lablabla/MoTrotten/PCB/UI_Board/GMT020-02 TFT SPI 240x320.STEP

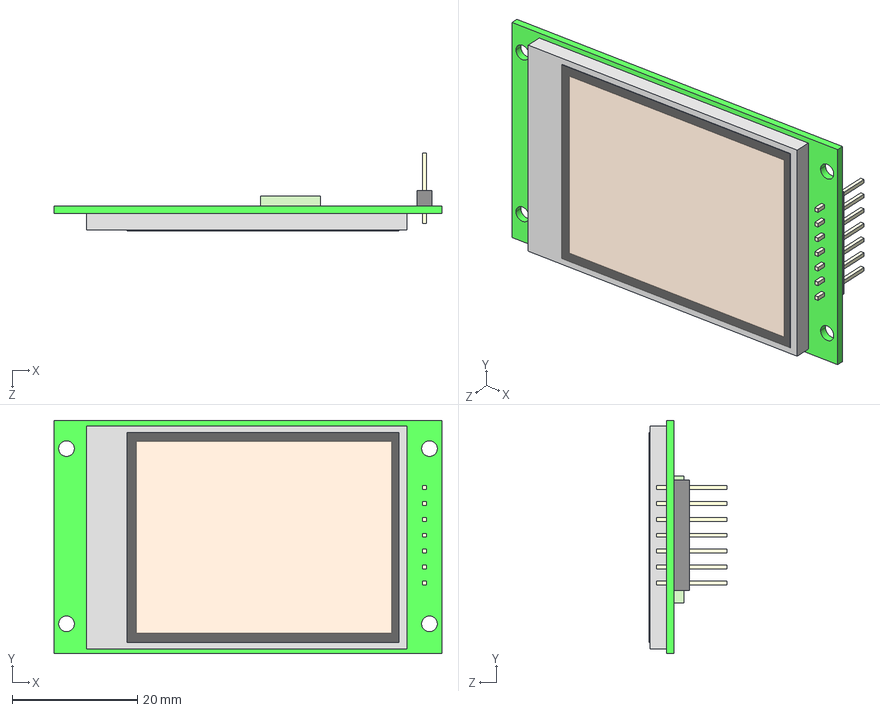
[picture p1: CAD file, 2026-07-06]
PCB/UI_Board/GMT020-02 TFT SPI 240x320.STEP
62.0 x 37.3 x 12.4 mm
