lablabla/MoTrotten/PCB/UI_Board/UI_Board.step

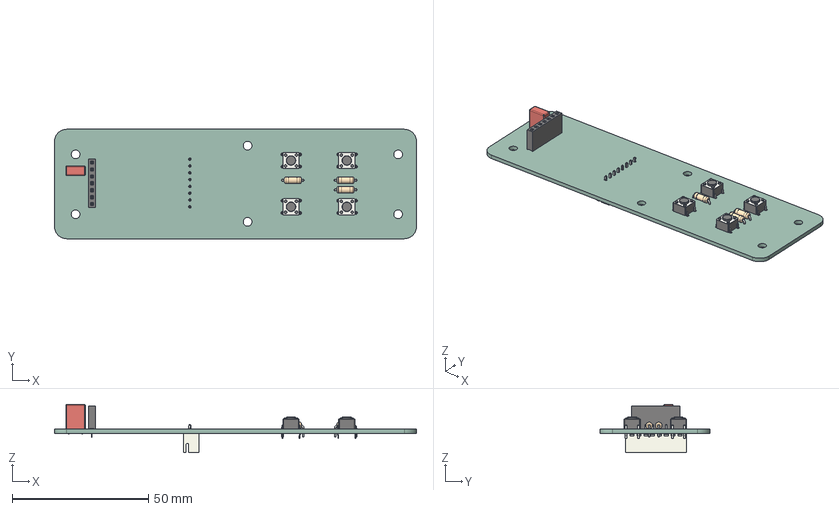
[picture p2: CAD file, 2026-07-06]
PCB/UI_Board/UI_Board.step
133.0 x 40.2 x 17.7 mm
C_Rect_L7.2mm_W3.5mm_P5.00mm_FKS2_FKP2_MKS2_MKP2
R_Axial_DIN0207_L6.3mm_D2.5mm_P7.62mm_Horizontal x 3
SW_PUSH_6mm x 4
PinSocket_1x07_P2.54mm_Vertical
JST_XH_B8B-XH-A_1x08_P2.50mm_Vertical
UI_Board_PCB
