lablabla/MoTrotten/PCB/Main_Board/Main_Board.pdf

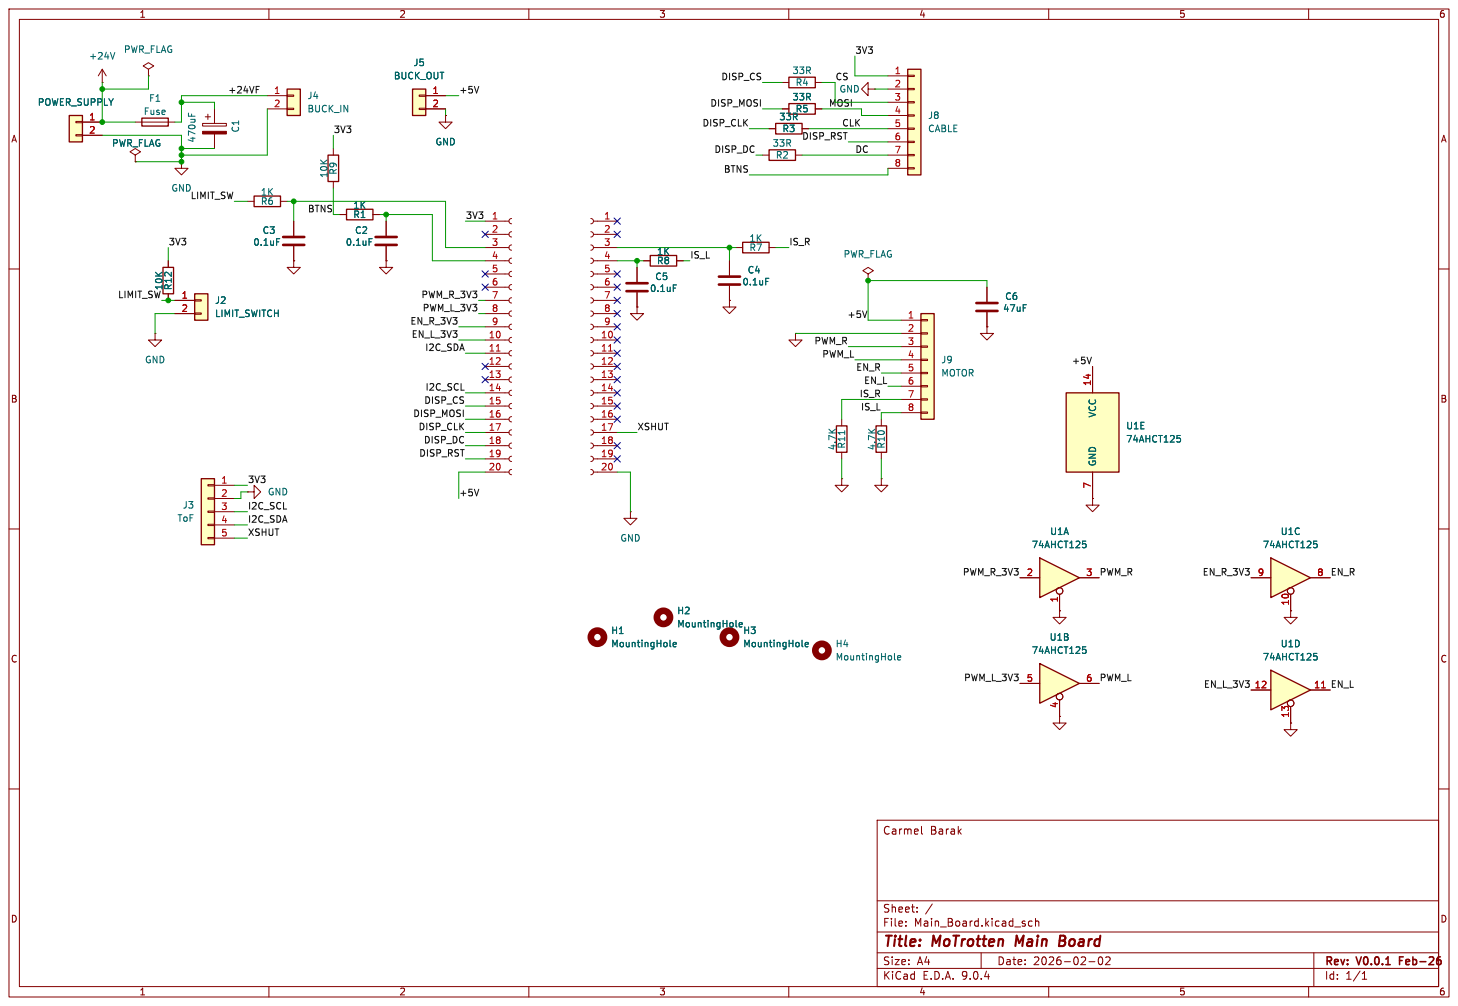
[picture p3: page 1]

Id: 1/1 Title: MoTrotten Main Board
