lablabla/MoTrotten/PCB/UI_Board/UI_Board.pdf

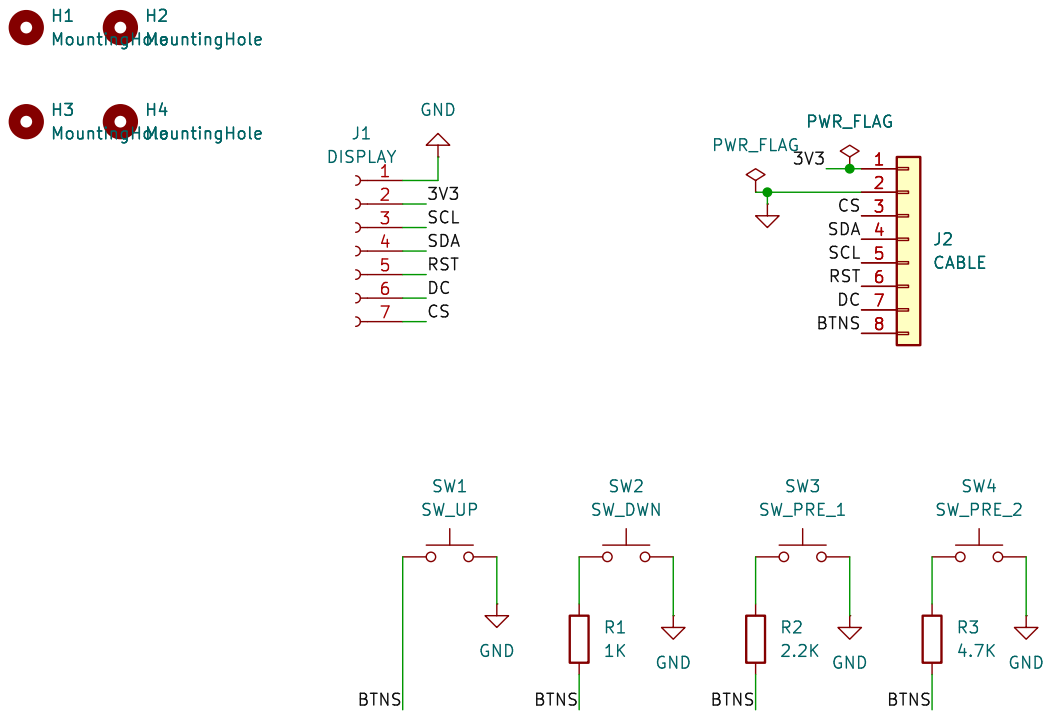
[picture p4: page 1]
