lablabla/MoTrotten/PCB/UI_Board/UI_Board.kicad_pcb

## KiCad design PCB/UI_Board/UI_Board.kicad_pcb (2026-07-06)

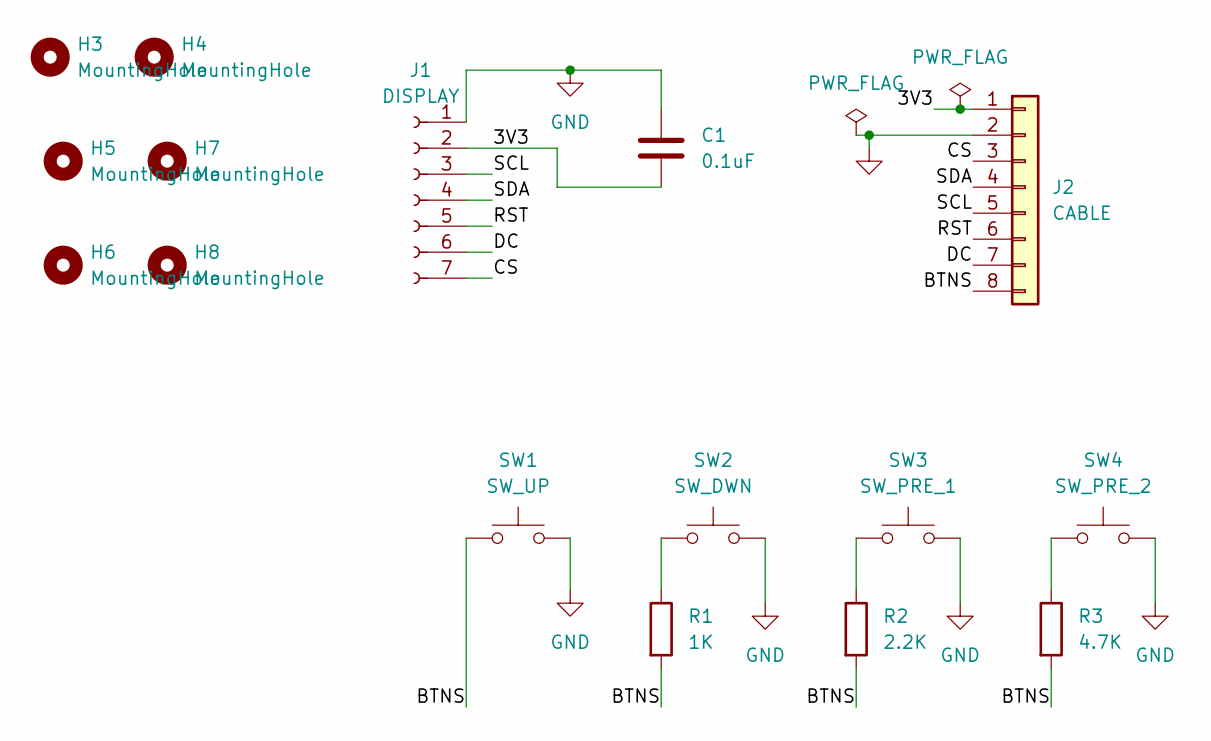
[picture p5: schematic UI_Board.kicad_sch, Motrotten UI]

Parts:
C1: 0.1uF; C_Rect_L7.2mm_W3.5mm_P5.00mm_FKS2_FKP2_MKS2_MKP2
H3, H4, H5, H6, H7, H8: MountingHole; MountingHole_3.2mm_M3
J1: DISPLAY; PinSocket_1x07_P2.54mm_Vertical
J2: CABLE; JST_XH_B8B-XH-A_1x08_P2.50mm_Vertical
R1: 1K; R_Axial_DIN0207_L6.3mm_D2.5mm_P7.62mm_Horizontal
R2: 2.2K; R_Axial_DIN0207_L6.3mm_D2.5mm_P7.62mm_Horizontal
R3: 4.7K; R_Axial_DIN0207_L6.3mm_D2.5mm_P7.62mm_Horizontal
SW1: SW_UP; SW_PUSH_6mm
SW2: SW_DWN; SW_PUSH_6mm
SW3: SW_PRE_1; SW_PUSH_6mm
SW4: SW_PRE_2; SW_PUSH_6mm

Connections:
/3V3: C1.2, J1.2, J2.1
/BTNS: J2.8, R1.2, R2.2, R3.2, SW1.1
/CS: J1.7, J2.3
/DC: J1.6, J2.7
/RST: J1.5, J2.6
/SCL: J1.3, J2.5
/SDA: J1.4, J2.4
GND: C1.1, J1.1, J2.2, SW1.2, SW2.2, SW3.2, SW4.2
unnamed: R1.1, SW2.1
unnamed: R2.1, SW3.1
unnamed: R3.1, SW4.1

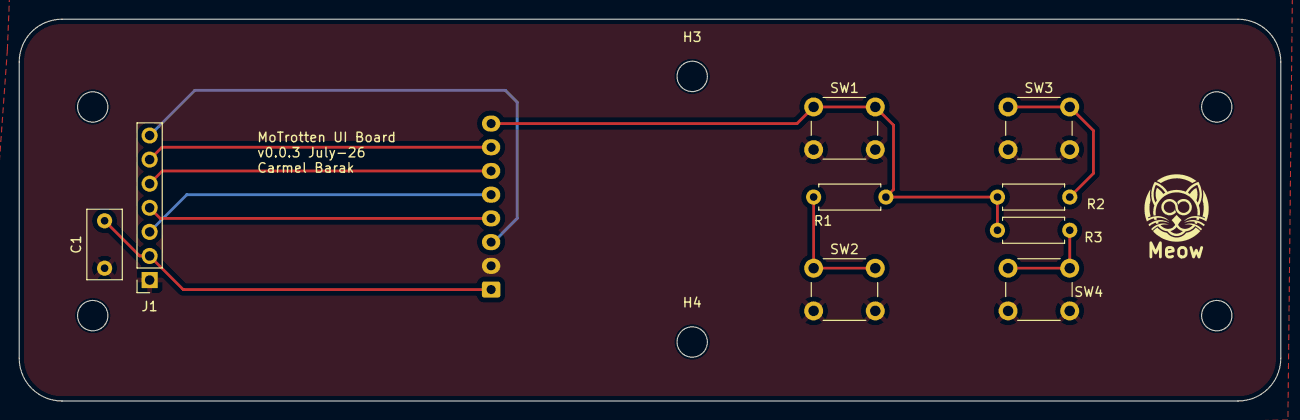
[picture p6: board UI_Board.kicad_pcb from above]

Board: 2 copper layers, 133.0 x 40.2 mm, 16 parts (1 on the bottom side), 11 nets.
