lablabla/MoTrotten/PCB/Main_Board/Main_Board.kicad_pcb

## KiCad design PCB/Main_Board/Main_Board.kicad_pcb (2026-07-06)

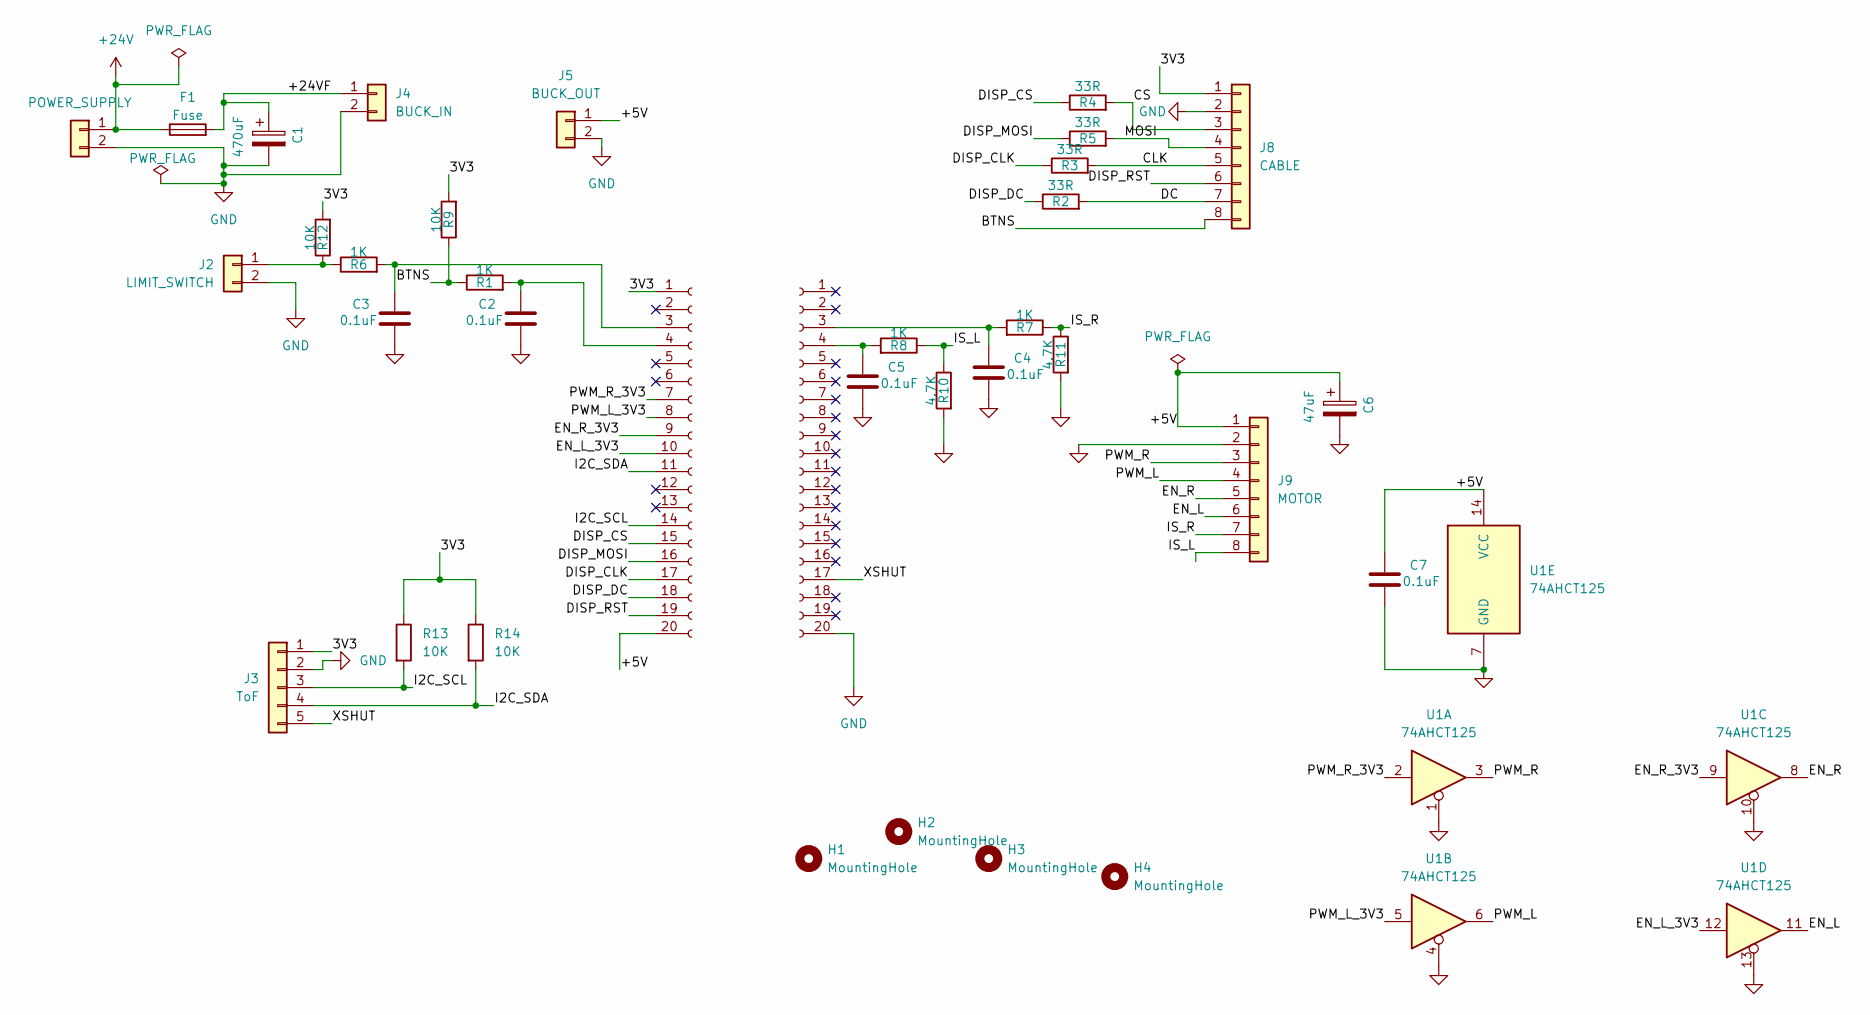
[picture p7: schematic Main_Board.kicad_sch, MoTrotten Main Board]

Parts:
C1: 470uF; CP_Radial_D10.0mm_P5.00mm
C2, C3, C4, C5, C7: 0.1uF; C_Rect_L7.2mm_W3.5mm_P5.00mm_FKS2_FKP2_MKS2_MKP2
C6: 47uF; CP_Radial_D10.0mm_P5.00mm
F1: Fuse; Fuseholder_Cylinder-5x20mm_Stelvio-Kontek_PTF78_Horizontal_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
H1, H2, H3, H4: MountingHole; MountingHole_3.2mm_M3
J1: POWER_SUPPLY; TerminalBlock_bornier-2_P5.08mm
J2: LIMIT_SWITCH; JST_PH_B2B-PH-K_1x02_P2.00mm_Vertical
J3: ToF; JST_PH_B5B-PH-K_1x05_P2.00mm_Vertical
J4: BUCK_IN; TerminalBlock_bornier-2_P5.08mm
J5: BUCK_OUT; TerminalBlock_bornier-2_P5.08mm
J6: ESP32_Left; PinSocket_1x20_P2.54mm_Vertical
J7: ESP32_Right; PinSocket_1x20_P2.54mm_Vertical
J8: CABLE; JST_XH_B8B-XH-A_1x08_P2.50mm_Vertical
J9: MOTOR; JST_XH_B8B-XH-A_1x08_P2.50mm_Vertical
R1, R6, R7, R8: 1K; R_Axial_DIN0207_L6.3mm_D2.5mm_P7.62mm_Horizontal
R2, R3, R4, R5: 33R; R_Axial_DIN0207_L6.3mm_D2.5mm_P7.62mm_Horizontal
R9, R12, R13, R14: 10K; R_Axial_DIN0207_L6.3mm_D2.5mm_P7.62mm_Horizontal
R10, R11: 4.7K; R_Axial_DIN0207_L6.3mm_D2.5mm_P7.62mm_Horizontal
U1: 74AHCT125; DIP-14_W7.62mm

Connections:
+24V: F1.1, J1.1
/3V3: J3.1, J6.1, J8.1, R9.2, R12.2, R13.1, R14.1
/+5V: C6.1, C7.1, J5.1, J6.20, J9.1, U1.14 (VCC)
/+24VF: C1.1, F1.2, J4.1
/BTNS: J8.8, R1.1, R9.1
/CLK: J8.5, R3.2
/CS: J8.3, R4.2
/DC: J8.7, R2.2
/DISP_CLK: J6.17, R3.1
/DISP_CS: J6.15, R4.1
/DISP_DC: J6.18, R2.1
/DISP_MOSI: J6.16, R5.1
/DISP_RST: J6.19, J8.6
/EN_L: J9.6, U1.11
/EN_L_3V3: J6.10, U1.12
/EN_R: J9.5, U1.8
/EN_R_3V3: J6.9, U1.9
/I2C_SCL: J3.3, J6.14, R13.2
/I2C_SDA: J3.4, J6.11, R14.2
/IS_L: J9.8, R8.1, R10.1
/IS_R: J9.7, R7.1, R11.1
/MOSI: J8.4, R5.2
/PWM_L: J9.4, U1.6
/PWM_L_3V3: J6.8, U1.5
/PWM_R: J9.3, U1.3
/PWM_R_3V3: J6.7, U1.2
/XSHUT: J3.5, J7.17
GND: C1.2, C2.2, C3.2, C4.2, C5.2, C6.2, C7.2, J1.2, J2.2, J3.2, J4.2, J5.2, J7.20, J8.2, J9.2, R10.2, R11.2, U1.1, U1.4, U1.7 (GND), U1.10, U1.13
unnamed: J2.1, R6.1, R12.1
unnamed: C3.1, J6.3, R6.2
unnamed: C2.1, J6.4, R1.2
unnamed: C4.1, J7.3, R7.2
unnamed: C5.1, J7.4, R8.2

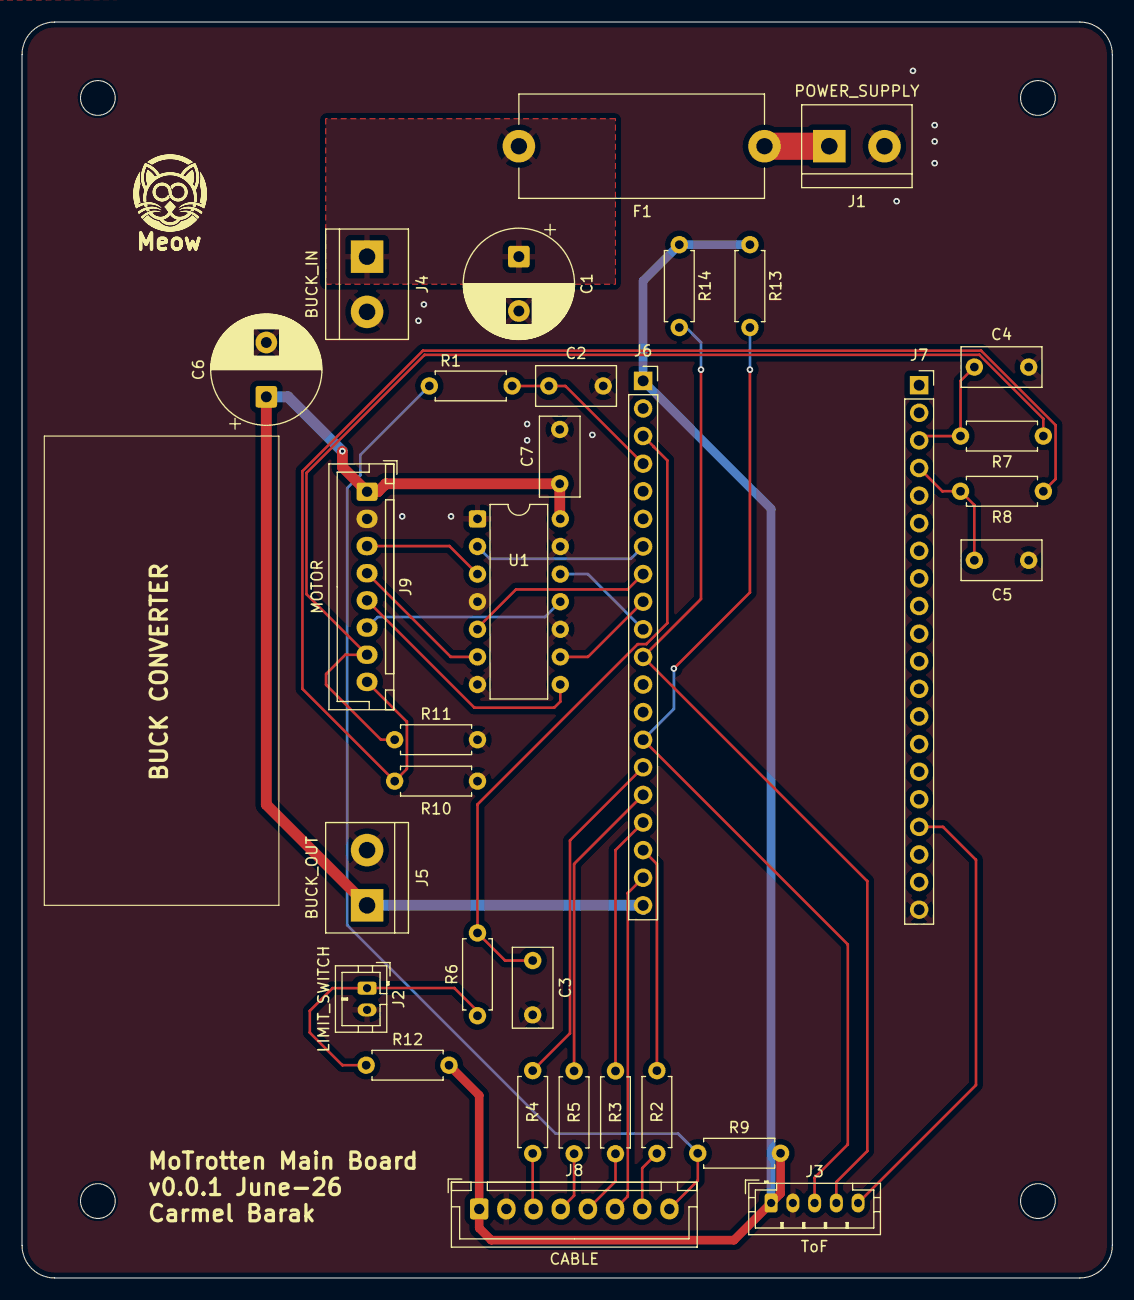
[picture p8: board Main_Board.kicad_pcb from above]

Board: 2 copper layers, 100.3 x 115.6 mm, 36 parts (0 on the bottom side), 33 nets.
