lablabla/MoTrotten/(commit log)

2025-12-12 Add display management and motor control features
    - Implement DisplayManager class for handling display initialization and rendering.
    - Create MotorDriver class for motor control with soft start and stop functionality.
    - Update CMakeLists.txt to include new source files.
    - Modify desk_config.h to add display pin configurations.
    - Enhance main.cpp with GUI task and motor control logic.
    - Update dependencies in idf_component.yml and dependencies.lock.
2025-12-12 Add UIManager class and integrate UI features
    - Introduced UIManager for managing UI elements and animations.
    - Updated display_manager to include new UI functionalities.
    - Modified main.cpp to utilize UIManager and manage UI states.
    - Adjusted CMakeLists.txt to include ui_manager.cpp.
    - Updated desk_config.h for display pin configuration.
    - Cleaned up commented code in main.cpp for better readability.
2025-12-13 Enhance sensor_task: Integrate I2C master bus and VL53L0X device initialization
2025-12-27 Add VL53L0X header file for time-of-flight distance sensor
2025-12-27 Refactor motor driver: Implement stall detection and improve I2C integration for VL53L0X sensor
    [desk_config.h, motor_driver.cpp, motor_driver.hpp]
2026-02-03 Initial PCB board commit. 1st revision of main board
    [Main_Board.kicad_pcb, Main_Board.kicad_sch]
2026-02-03 Minor fixes
    [Main_Board.kicad_pcb, Main_Board.kicad_sch]
2026-02-04 Added UI board Cosmetics in main board
    [Main_Board.kicad_pcb, UI_Board.kicad_pcb, UI_Board.kicad_sch]
2026-02-07 Cleanup main board + fixed GPIOs used
    [Main_Board.kicad_pcb, Main_Board.kicad_sch]
2026-02-09 Added fuse + cleanups
    [Main_Board.kicad_pcb, Main_Board.kicad_sch]
2026-02-21 Updated boards and added DRU files
    [Main_Board.kicad_pcb, Main_Board.kicad_sch, UI_Board.kicad_pcb]
2026-02-23 Updated boards
    [Main_Board.kicad_pcb, Main_Board.kicad_sch, UI_Board.kicad_pcb, UI_Board.kicad_sch]
2026-03-13 docs: add software design, architecture, and project summary
    Complete software design document (Rev 2) capturing the full
    architecture, state machine, module responsibilities, task/core
    allocation, and all design decisions. Adds hardware wiring/pinout
    reference, system overview/BOM, and project summary.
2026-03-13 build: update CMakeLists, desk_config, and component manifest
    Register all new source files (app_main, button_reader, height_sensor,
    nvs_manager) and VL53L0X. Add correct IDF component dependencies.
    Rewrite desk_config.h with final PCB GPIO assignments, LEDC config
    (5kHz 10-bit), ADC channels, NVS keys, and FreeRTOS task parameters.
    Remove espp/logger dependency from idf_component.yml.
    [desk_config.h]
2026-03-13 feat(motor): non-blocking ramp state machine with stall detection
    Replace blocking ramp in move_up/down with a MotorState enum-driven
    state machine running in motor_mon_task (Core 0, prio 6). All public
    commands (move_up, move_down, stop, emergency_stop) return immediately
    after a portENTER_CRITICAL state transition. The monitor loop owns
    duty ramping, inrush window, and stall detection via current sense ADC.
    ADC unit handle exposed for sharing with ButtonReader.
    [motor_driver.cpp, motor_driver.hpp]
2026-03-13 feat(buttons): add ButtonReader with poll/state/edge split
    Reads 4-button ADC ladder on a single GPIO. poll() advances debounce
    state machine each app_task cycle. state() returns held button for
    hold-to-move. edge() returns rising edge for one-shot preset actions.
    Shares ADC unit handle with MotorDriver.
2026-03-13 feat(sensor): add HeightSensor wrapping VL53L0X over i2c_master
    Initialises I2C master bus and device handle, passes dev_handle to
    VL53L0X. read_mm() returns calibrated height (calib_offset - raw)
    once calibrated, raw distance otherwise. Validates against timeout
    and out-of-range (65535) sentinel.
2026-03-13 feat(nvs): add NvsManager for preset and calibration persistence
    Stores sit_mm, stand_mm, and calib_offset in NVS namespace. Handles
    ESP_ERR_NVS_NO_FREE_PAGES by erasing and reinitialising. Separate
    save_calib_offset() avoids rewriting presets during calibration.
    Defaults: sit=730mm, stand=1100mm, calib_offset=0 (triggers calib).
    [nvs_manager.cpp, nvs_manager.hpp]
2026-03-13 feat(display): rewrite DisplayManager for ST7789 240x240 with DMA safety
    Add flush semaphore: notify_flush_ready gives from ISR, flush_cb waits
    before calling lv_disp_flush_ready — prevents LVGL touching a buffer
    still in DMA transfer. Store panel/IO handles as members (were lost
    locals). Add esp_timer 1ms tick. Fix 240x240 resolution (was 320x240).
    [display_manager.cpp, display_manager.hpp]
2026-03-13 feat(ui): rewrite UIManager with full desk state transitions
    Add show_idle, show_moving_up/down, show_goto_preset, show_stalled,
    show_calibrating, show_saved_confirmation. Single overlay_label_ for
    all transient text. Stall shows red background + BLOCKED, restored
    after 2s via lv_timer. Saved! auto-hides after 1.5s. Retain startup
    letter animation and arrow animation with trail effect.
    [ui_manager.cpp, ui_manager.hpp]
2026-03-13 feat(app): implement full application state machine in app_main
    Replace stub main.cpp with app_main.cpp. DeskState holds volatile
    app_state, current_height_mm, stall_detected, goto_target_mm, and
    presets. Two tasks: lvgl_task (Core 1) drives display; app_task
    (Core 0) owns the 50ms control loop.
    app_task: height read → stall handling (2s recovery) → button poll
    → GOTO_PRESET non-blocking state machine → hold-to-move with soft
    limits → preset edge + hold-to-save gesture. Zero-allocation
    lv_async_call pattern via static callbacks reading &g_state.
    app_main: NVS → motor → buttons (shared ADC) → sensor → mutex →
    stall callback → lvgl_task → wait startup → calibration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
    [app_main.cpp, main.c]
2026-03-13 chore: update UI board files and add build script
    Update UI board KiCad project, schematic, and PCB. Add manufacturing
    outputs (PDF, STEP, BOM). Add TFT display STEP model. Add
    build_esp32s3.ps1 helper script for building under Windows PowerShell
    without the IDF export.ps1 (works around MSYSTEM/py env mismatch).
    [GMT020-02 TFT SPI 240x320.STEP, UI_Board.kicad_pcb, UI_Board.kicad_sch, UI_Board.step]
2026-03-29 Added decoupling capacitor to AHCT
    [Main_Board.kicad_pcb, Main_Board.kicad_sch]
2026-05-30 fix(motor): recalculate IS stall threshold for 2.2kΩ drain resistors
    R_IS changed from 4.7kΩ to 2.2kΩ (substituted part).
    Recalculated constants:
    At 4.4A stall: V_IS = (4.4/8500)*2200 = 1.14V → raw 1413
    Threshold at ~92% of stall: 1300 (was 2800 with 4.7kΩ)
    Updated comment with new formula. Added tuning note — threshold
    should be validated empirically against actual running current.
    [desk_config.h]
2026-05-30 feat(test): add hw_test.cpp standalone test firmware
    Serial-menu-driven test app covering all components individually:
    1 - EN GPIO toggle (verify BTS7960 enable lines)
    2 - PWM output sweep (verify LEDC channels on scope)
    3/4 - Motor run UP/DOWN 2s (verify H-bridge and wiring)
    5 - Current sense ADC readings with I/V conversion printout
    6 - Button ADC ladder decode (all 4 buttons)
    7 - VL53L0X I2C scan + model ID register check
    8 - Limit switch GPIO read
    To use: swap app_main.cpp for hw_test.cpp in CMakeLists.txt SRCS.
    115200 baud serial monitor.
    [hw_test.cpp]
2026-05-30 docs: add hardware test plan with expected values and pass criteria
    Covers all 8 component tests matching hw_test.cpp:
    - GPIO/PWM verification procedures
    - Motor run safety notes and pass criteria
    - Current sense ADC table (2.2kΩ) with I/V/raw at key currents
    - Button ladder expected raw windows for all 4 buttons
    - VL53L0X I2C diagnosis table
    - Limit switch open/triggered verification
    - Stall threshold tuning worksheet
    [hw_test.cpp]
2026-06-03 fix(motor): keep both EN pins HIGH; update IS test to run motor simultaneously
    motor_driver.cpp: Both PIN_MOTOR_EN_R and PIN_MOTOR_EN_L must be HIGH
    during movement. EN_idle=0 floats the output — M+ and M- equalise at
    24V giving 0V across the motor. Direction is set by which PWM channel
    carries duty > 0; the idle channel stays at duty=0 (low-side → GND).
    EN pins are disabled only after ramp-down reaches duty=0.
    hw_test.cpp test 5: replace static IS readings with integrated motor
    run. Sequence: at-rest baseline → ramp UP + IS sampling → rest →
    ramp DOWN + IS sampling → rest. IS is sampled every 200ms throughout
    each ramp and full-speed phase so the stall threshold can be tuned
    ag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
    [hw_test.cpp, motor_driver.cpp]
2026-06-03 Add junctions and wires for improved connectivity on Main Board schematic
    - Introduced multiple junctions at specified coordinates to enhance circuit connections.
    - Updated wire connections to reflect new junction placements and ensure proper routing.
    - Adjusted component positions and labels for clarity and consistency.
    - Added two resistors (R13 and R14) with specified values and footprints to the schematic.
    - Updated GND symbol and its properties to align with new layout.
    [Main_Board.kicad_pcb, Main_Board.kicad_sch]
2026-06-03 feat(test): add VL53L0X range test (t) and display diagnostic improvements
    Test 't': inits the VL53L0X library over i2c_master, takes 30
    single-shot range readings at 200ms intervals, prints mm/cm and
    flags timeouts. Verified working on hardware.
    Display diagnostic (d): software byte-swap via __builtin_bswap16
    in disp_fill() instead of missing swap_color_bytes driver flag.
    display_reset_panel() now nulls s_panel so display_ready() re-inits
    correctly between variants. display_ready() accepts bgr param.
    Six labelled variants A-F cover swap_bytes × swap_xy × invert.
    [hw_test.cpp]
2026-06-03 docs: add current software design document with analysis
    Covers RTOS task architecture (3 tasks, cores, priorities, stacks),
    full init sequence, state machine, button functions, module internals,
    NVS schema, and 12 identified issues cross-referenced against hw_test.
    Critical issues flagged:
    - C1: display byte swap unresolved (colors wrong)
    - C2: unused esp_task_wdt.h include
    - C3: GOTO_PRESET overshoot correction races with motor stop ramp
2026-06-12 Port full firmware rewrite from claude_impl: LEDC motor driver with stall detection, button/height/NVS managers, hw_test harness
    Replaces the legacy MCPWM-based main.cpp/motor_driver with app_main.cpp
    and the new module set (button_reader, height_sensor, nvs_manager) used
    by hw_test.cpp. Pin/PWM/current-sense config in desk_config.h now matches
    hw_test.cpp exactly. display_manager carried over unchanged.
    [app_main.cpp, button_reader.cpp, button_reader.hpp, desk_config.h, display_manager.cpp, display_manager.hpp, height_sensor.cpp, height_sensor.hpp]
2026-07-06 Updated PCB files
    [Main_Board.kicad_pcb, UI_Board.kicad_pcb, UI_Board.kicad_sch, UI_Board.step]
2026-07-06 Fixed display socket orientation and rotated cable JST socket to match
    [UI_Board.kicad_pcb]
